seif-aldeen/BLDC-Motor-Controller/commutation_sequence.png

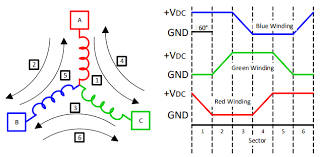
commutation_sequence.png
