seif-aldeen/BLDC-Motor-Controller/(list of files, drawings)

Other design files:
BLDC ESC V1.1.pdsprj
