seif-aldeen/BLDC-Motor-Controller/(commit log)

2026-05-20 Create Arduino_Code
2026-05-20 Update Arduino_Code
